BBALEJO/Uli/hardware/conexion.png

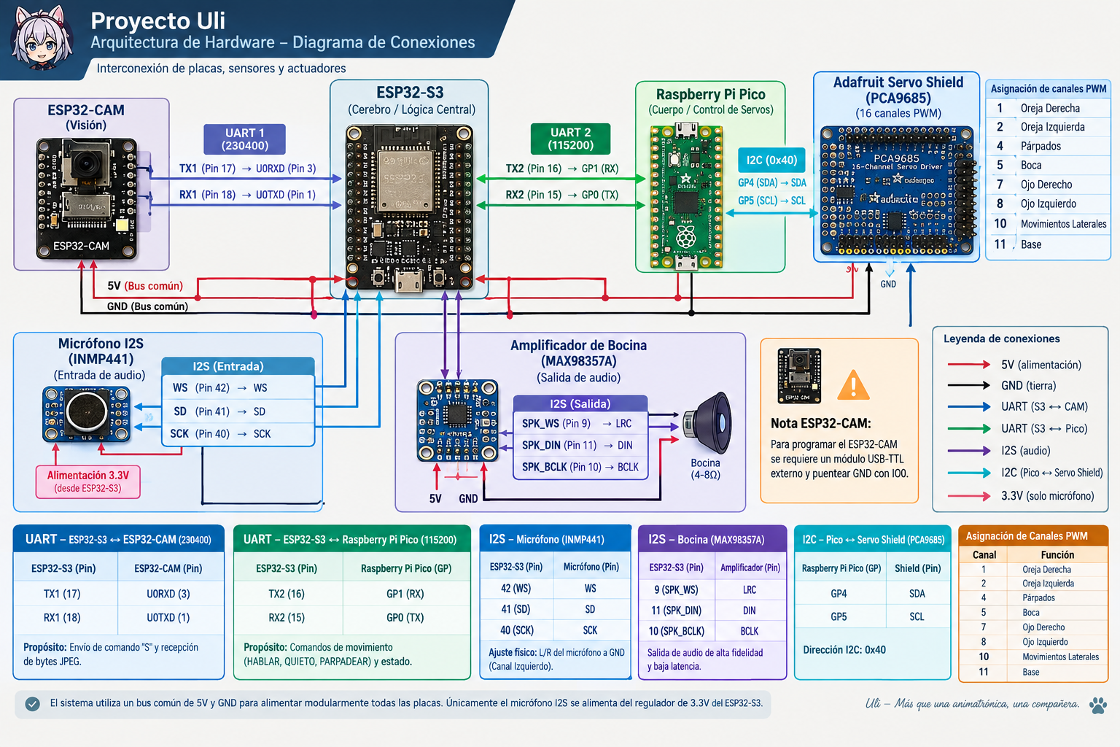
hardware/conexion.png
