BBALEJO/Uli/(commit log)

2026-09-28 Crear TestServosPwm
    Documentación codigo para obtener valores máximos y mínimos de los siervos en el animatrónico
2026-09-29 Actualizacion requerimientos para correr
